nhdthnh/Thesis/4. NCKH.jpg

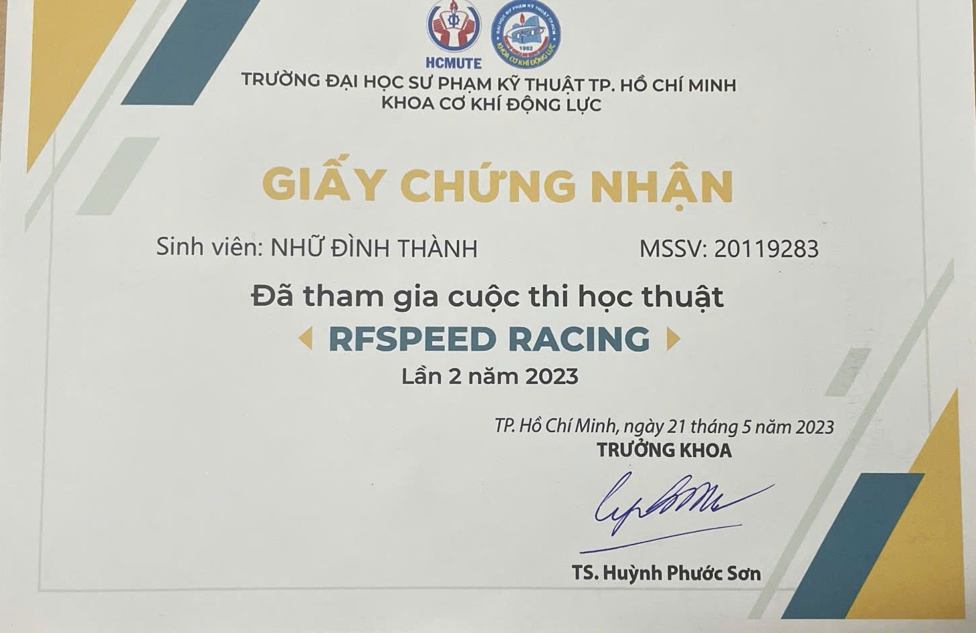
4. NCKH.jpg
