nhdthnh/Thesis/5.NCKH.jpg

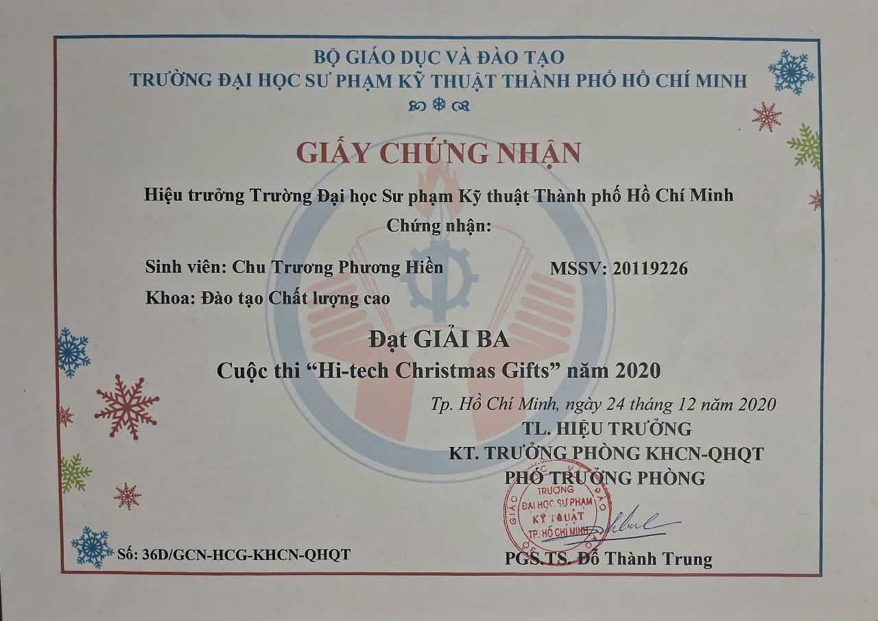
5.NCKH.jpg
