nhdthnh/Thesis/2025-01-10_134918.pdf

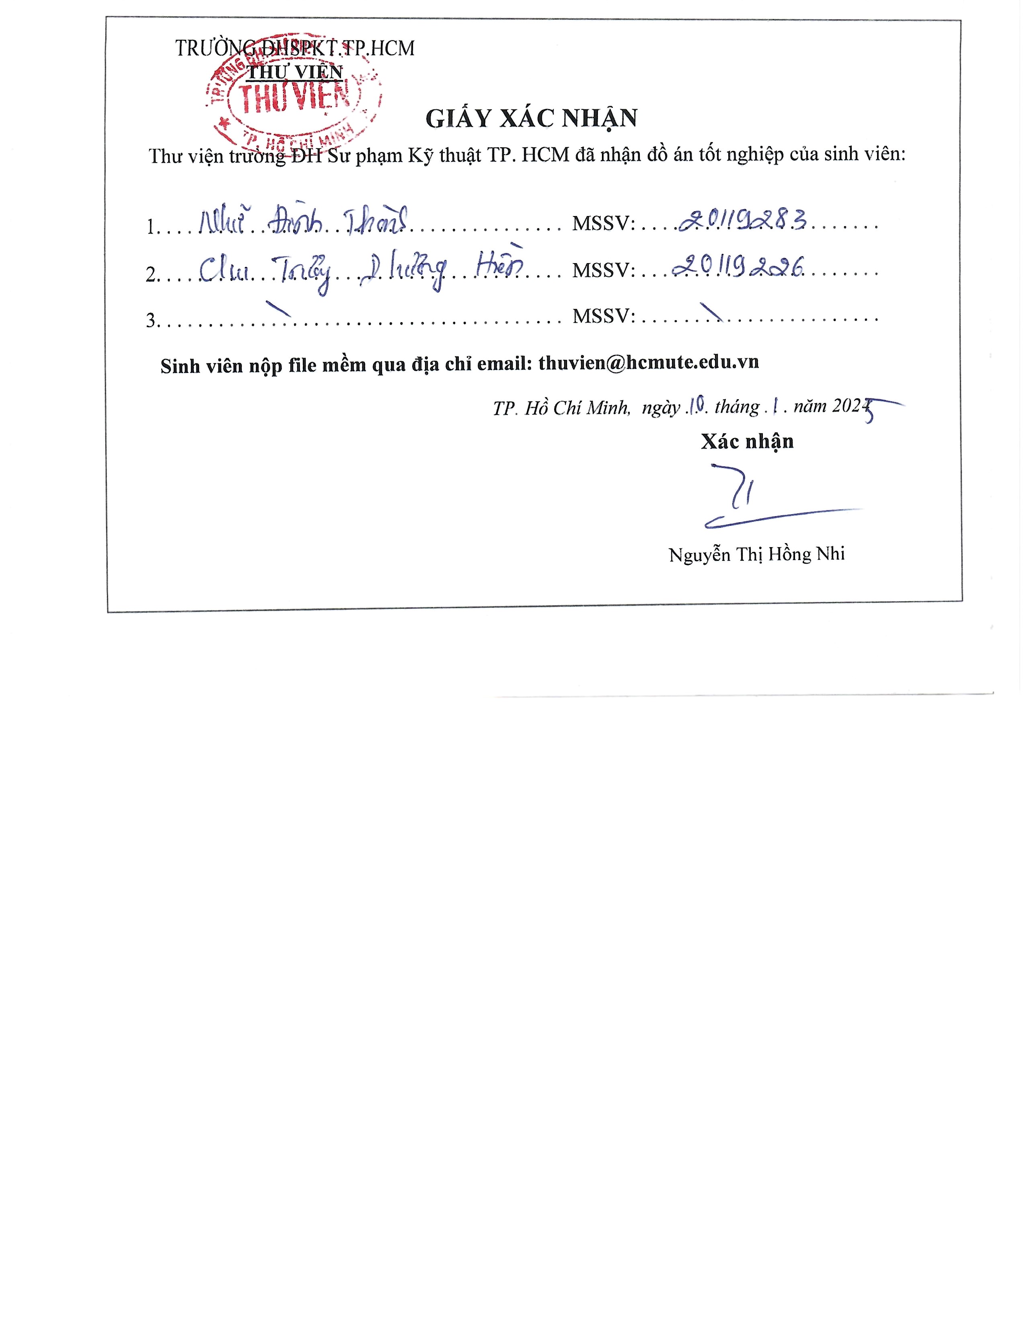
[picture p3: page 1]
