nhdthnh/Thesis/Nhan xet GVHD_Dinh Thanh Phuong Hien.pdf

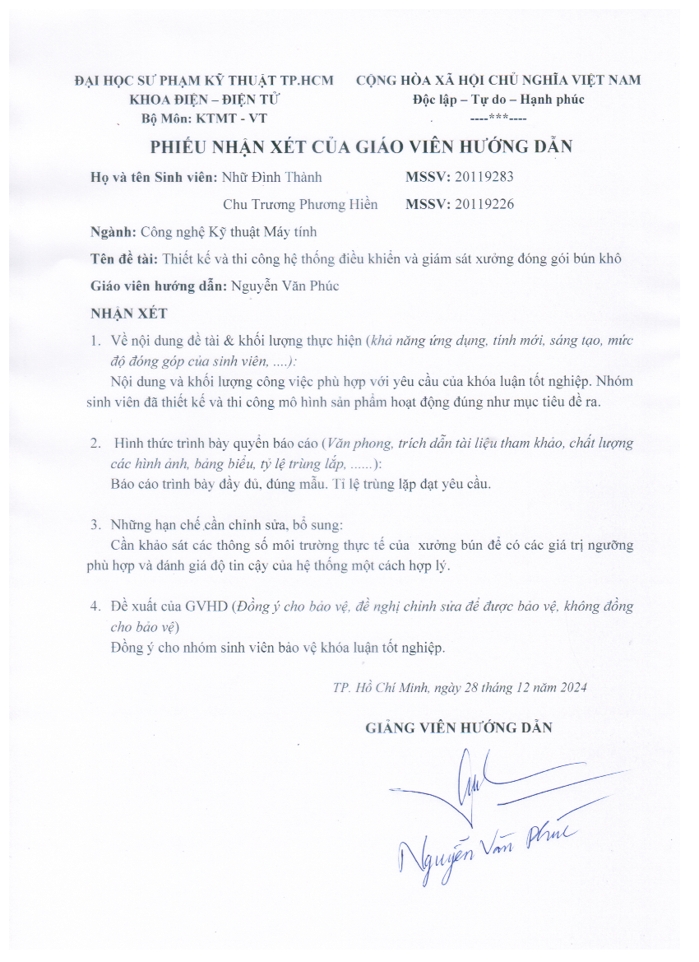
[picture p4: page 1]
