nhdthnh/Thesis/CODE HW/UNO1/LoRaSimple.h

#include <SoftwareSerial.h>

SoftwareSerial lora(6, 7);

void setupLoRa() {
  lora.begin(9600);
}

void sendLoRa(String s) {
  lora.print(s);
}

void processDataLoRa(String s) {
  if (s == "0-1-Request 1" || s.indexOf("0-1") != -1) { // Kiểm tra chính xác hoặc chuỗi chứa "0-1"
    sendLoRa("1-0-LOCATION 1 ONLINE\n");
    connected = true;
    displaySensor();
  }

       if (s.substring(0, 5) == "0-1-T") thresholdTemp = s.substring(6, s.length()).toInt();
  else if (s.substring(0, 5) == "0-1-H") thresholdHumi = s.substring(6, s.length()).toInt();
  else if (s.substring(0, 5) == "0-1-A") thresholdAQ = s.substring(6, s.length()).toInt();
  else if (s.substring(0, 5) == "0-1-R" && s.length() < 11) {
    relayState[String(s[5]).toInt()-1] = s[7] == '1';
    Serial.println("relay "+String(s[5])+" state "+String(s[7]));
  }
}

void checkLoRa() {
  if (lora.available()) {
    String data = lora.readStringUntil('\n');
    Serial.println("Received from lora: "+data);
    processDataLoRa(data);
    displaySensor();
  }
}
